vsi5004/BatteryEnvironmentalSensor/Mechanical/Desktop Assembly v3.step

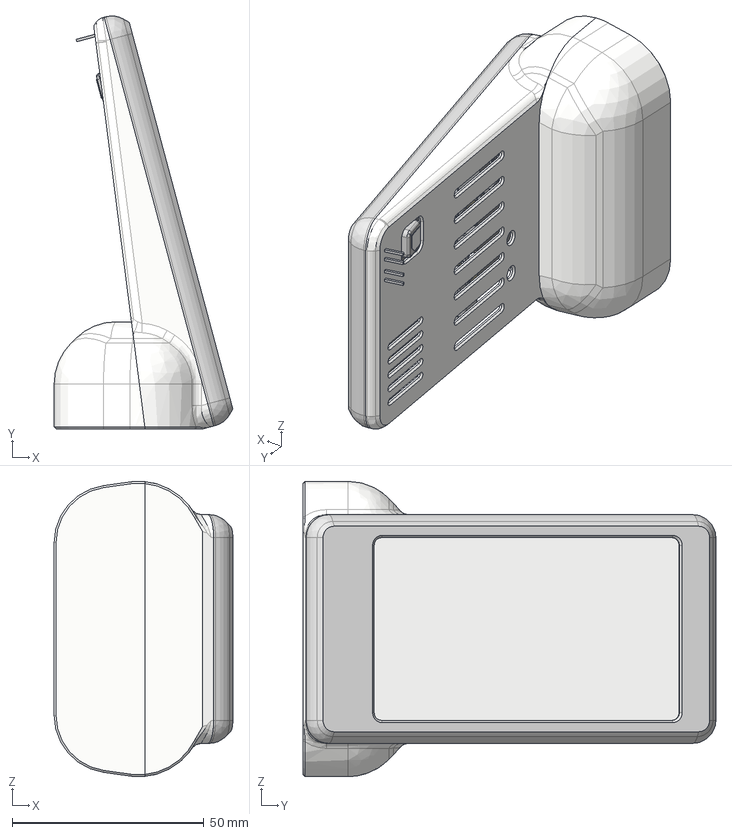
[picture p6: CAD file, 2026-04-04]
Mechanical/Desktop Assembly v3.step
46.7 x 107.8 x 77.1 mm
Board
10uF x 7
AP2112/RT9080-3.3 x 3
MBR540
JSTPH
RED x 2
1uF x 12
KMR2 x 2
DMG3415U
USB C
ESP32-S2-MODULE_MINI
LC709203F/MH
JST SH
WS2812B_SK6805_1515
BME280
10uF_1
10K
Board_1
10uF_2 x 2
AP2112K-3.3
10K_1 x 2
10K_2
BSS138
STEMMA_I2C_QT x 2
GREEN
SHT4X_
Komponente1
Komponente1 (1)
Komponente2
Komponente3
18650 Battery
R0603 x 5
Extruded x 5
COMPOUND.step
User Library-SOT23-3
Mid_Body x 7
Mark x 7
Mid_Body_1
Mark_1
Mid_Body_2
Mark_2
Leader x 3
Extruded_1
FH34SRJ-24S-0.5SH_RGB4408131
SOD323 x 3
Front Lid
Back Lid
