vsi5004/BatteryEnvironmentalSensor/Mechanical/Back Lid.3mf

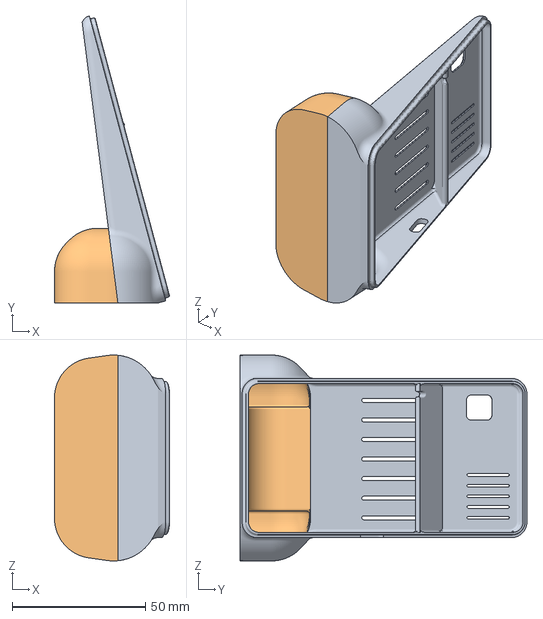
[picture p7: CAD file, 2026-04-04]
Mechanical/Back Lid.3mf
43.1 x 107.5 x 77.1 mm
