vsi5004/BatteryEnvironmentalSensor/Mechanical/Front Lid.3mf

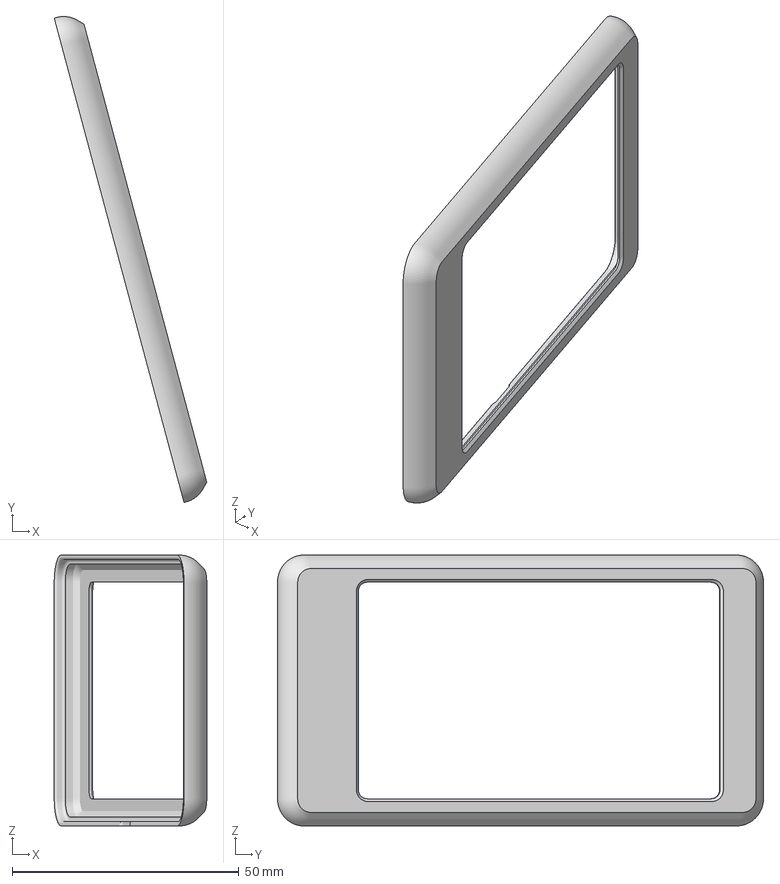
[picture p8: CAD file, 2026-04-04]
Mechanical/Front Lid.3mf
33.6 x 107.1 x 59.7 mm
