vsi5004/BatteryEnvironmentalSensor/(list of files, cad)

Other CAD files:
Mechanical/Desktop Assembly.f3z
