vsi5004/BatteryEnvironmentalSensor/(commit log)

2026-04-04 Initial commit: firmware, mechanical files, and documentation
    [Back Lid.3mf, Desktop Assembly v3.step, Desktop Assembly.f3z, Front Lid.3mf]
2026-04-04 Fix SCD41 warmup shot explanation; update wiring, assembly, and README docs
2026-11-02 Fix firmware timing and simplify wake-cycle structure
    [Firmware.ino, config.example.h, debug.h, display.cpp, display.h]
